Appletea404/Project_6_Digiscope/images/DIGISCOPE_Gitgraph.png

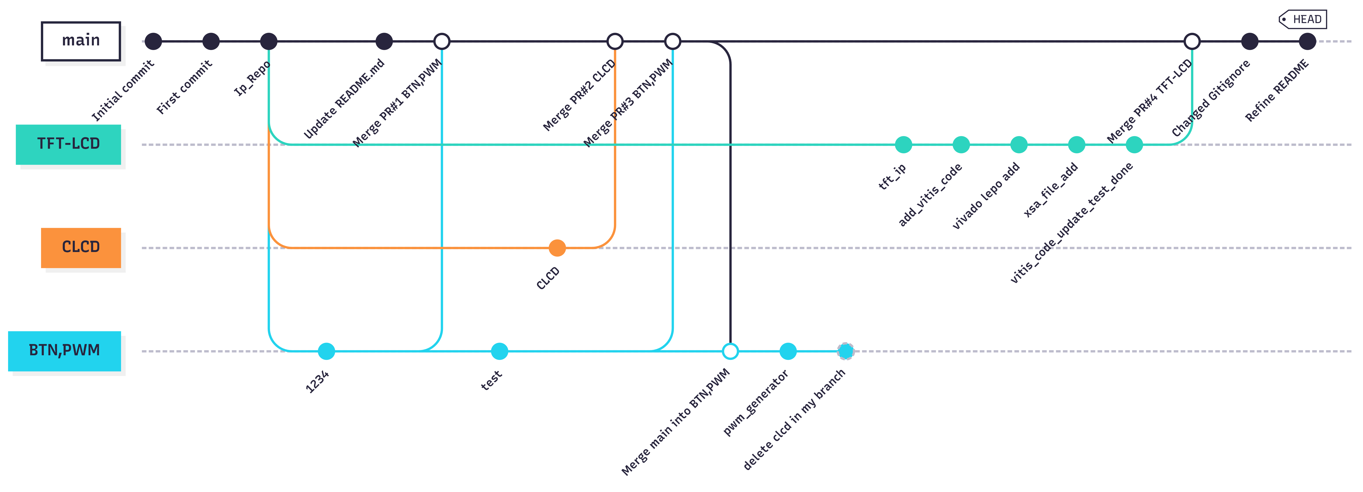
images/DIGISCOPE_Gitgraph.png
