Appletea404/Project_6_Digiscope/Vitis/platform_DIGISCOPE_TEST1/microblaze_riscv_0/standalone_microblaze_riscv_0/bsp/include/xparameters.h

#ifndef XPARAMETERS_H   /* prevent circular inclusions */
#define XPARAMETERS_H   /* by using protection macros */

#define XPAR_XGPIO_NUM_INSTANCES 1

/* Definitions for peripheral AXI_GPIO_0 */
#define XPAR_AXI_GPIO_0_COMPATIBLE "xlnx,axi-gpio-2.0"
#define XPAR_AXI_GPIO_0_BASEADDR 0x40000000
#define XPAR_AXI_GPIO_0_HIGHADDR 0x4000ffff
#define XPAR_AXI_GPIO_0_INTERRUPT_PRESENT 0x0
#define XPAR_AXI_GPIO_0_IS_DUAL 0x0
#define XPAR_AXI_GPIO_0_GPIO_WIDTH 0x4

/* Canonical definitions for peripheral AXI_GPIO_0 */
#define XPAR_XGPIO_0_BASEADDR 0x40000000
#define XPAR_XGPIO_0_HIGHADDR 0x4000ffff
#define XPAR_XGPIO_0_COMPATIBLE "xlnx,axi-gpio-2.0"
#define XPAR_XGPIO_0_GPIO_WIDTH 0x4
#define XPAR_XGPIO_0_INTERRUPT_PRESENT 0x0
#define XPAR_XGPIO_0_IS_DUAL 0x0

#define XPAR_XUARTLITE_NUM_INSTANCES 1

/* Definitions for peripheral AXI_UARTLITE_0 */
#define XPAR_AXI_UARTLITE_0_COMPATIBLE "xlnx,axi-uartlite-2.0"
#define XPAR_AXI_UARTLITE_0_BASEADDR 0x40600000
#define XPAR_AXI_UARTLITE_0_HIGHADDR 0x4060ffff
#define XPAR_AXI_UARTLITE_0_BAUDRATE 0x2580
#define XPAR_AXI_UARTLITE_0_USE_PARITY 0x0
#define XPAR_AXI_UARTLITE_0_ODD_PARITY 0x0
#define XPAR_AXI_UARTLITE_0_DATA_BITS 0x8

/* Canonical definitions for peripheral AXI_UARTLITE_0 */
#define XPAR_XUARTLITE_0_BASEADDR 0x40600000
#define XPAR_XUARTLITE_0_HIGHADDR 0x4060ffff
#define XPAR_XUARTLITE_0_BAUDRATE 0x2580
#define XPAR_XUARTLITE_0_COMPATIBLE "xlnx,axi-uartlite-2.0"
#define XPAR_XUARTLITE_0_DATA_BITS 0x8
#define XPAR_XUARTLITE_0_ODD_PARITY 0x0
#define XPAR_XUARTLITE_0_USE_PARITY 0x0

/* Definitions for peripheral CLCD_0 */
#define XPAR_CLCD_0_BASEADDR 0x44a00000
#define XPAR_CLCD_0_HIGHADDR 0x44a0ffff

/* Canonical definitions for peripheral CLCD_0 */
#define XPAR_CLCD_0_BASEADDR 0x44a00000
#define XPAR_CLCD_0_HIGHADDR 0x44a0ffff

/* Definitions for peripheral MYIP_PWM_0 */
#define XPAR_MYIP_PWM_0_BASEADDR 0x44a20000
#define XPAR_MYIP_PWM_0_HIGHADDR 0x44a2ffff

/* Canonical definitions for peripheral MYIP_PWM_0 */
#define XPAR_MYIP_PWM_0_BASEADDR 0x44a20000
#define XPAR_MYIP_PWM_0_HIGHADDR 0x44a2ffff

/* Definitions for peripheral MYIP_TFT_LCD_CNTR_0 */
#define XPAR_MYIP_TFT_LCD_CNTR_0_BASEADDR 0x44a10000
#define XPAR_MYIP_TFT_LCD_CNTR_0_HIGHADDR 0x44a1ffff

/* Canonical definitions for peripheral MYIP_TFT_LCD_CNTR_0 */
#define XPAR_MYIP_TFT_LCD_CNTR_0_BASEADDR 0x44a10000
#define XPAR_MYIP_TFT_LCD_CNTR_0_HIGHADDR 0x44a1ffff

/*  BOARD definition */
#define XPS_BOARD_BASYS3

#define XPAR_LMB_BRAM_0_BASEADDRESS 0x0
#define XPAR_LMB_BRAM_0_HIGHADDRESS 0x1ffff

/*  CPU parameters definition */
#define XPAR_CPU_CORE_CLOCK_FREQ_HZ 100000000
#define XPAR_MICROBLAZE_RISCV_USE_DCACHE 0
#define XPAR_MICROBLAZE_RISCV_DCACHE_LINE_LEN 4
#define XPAR_MICROBLAZE_RISCV_DCACHE_BYTE_SIZE 8192
#define XPAR_MICROBLAZE_RISCV_USE_ICACHE 0
#define XPAR_MICROBLAZE_RISCV_ICACHE_LINE_LEN 4
#define XPAR_MICROBLAZE_RISCV_ICACHE_BYTE_SIZE 8192
#define XPAR_MICROBLAZE_RISCV_USE_FPU 0
#define XPAR_MICROBLAZE_RISCV_USE_MMU 0
#define XPAR_MICROBLAZE_RISCV_USE_SLEEP 0
#define XPAR_MICROBLAZE_RISCV_FAULT_TOLERANT 0
#define XPAR_MICROBLAZE_RISCV_D_LMB 1
#define XPAR_MICROBLAZE_RISCV_USE_BRANCH_TARGET_CACHE 0
#define XPAR_MICROBLAZE_RISCV_BRANCH_TARGET_CACHE_SIZE 0

/* Number of SLRs */
#define NUMBER_OF_SLRS 0x1

/* Device ID */
#define XPAR_DEVICE_ID "7a35t"

#endif  /* end of protection macro */
