Appletea404/Project_6_Digiscope/Vitis/app_DIGISCOPE_TEST1/src/def.h

#ifndef DEF_H
#define DEF_H

/******************************************************************************
* Standard C
******************************************************************************/
#include <stdio.h>
#include <stdint.h>
#include <stdlib.h>
#include <string.h>

/******************************************************************************
* Xilinx BSP
******************************************************************************/
#include "platform.h"
#include "xparameters.h"
#include "xil_printf.h"
#include "xil_io.h"
#include "xil_types.h"
#include "xuartlite_l.h"

/******************************************************************************
* Delay
******************************************************************************/
#include "sleep.h"

#endif
